marsairforce/vusbtiny/pcb/eagle/vusbtiny.brd

## EAGLE design pcb/eagle/vusbtiny.brd (2018-04-26)

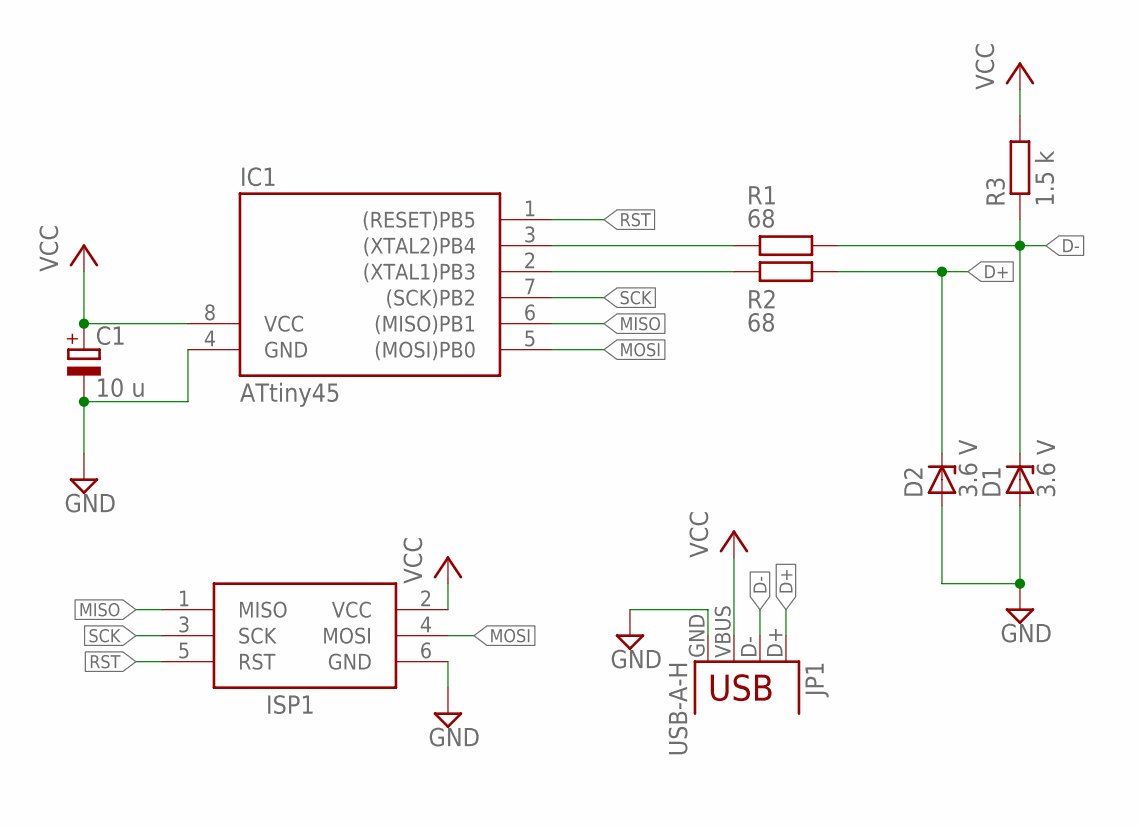
[picture p5: schematic vusbtiny.sch]

Parts:
C1: 10 u; E2,5-5
D1, D2: 3.6 V; DO34Z7
IC1: ATtiny45; DIL08
ISP1: AVRISP-6; AVRISP
JP1: USB-A-H
R1, R2: 68; 0207/10
R3: 1.5 k; 0207/10

Connections:
D+: D2.C, JP1.D+, R2.2
D-: D1.C, JP1.D-, R1.2, R3.1
GND: C1.-, D1.A, D2.A, IC1.4 (GND), ISP1.6 (GND), JP1.GND
MISO: IC1.6 ((MISO)PB1), ISP1.1 (MISO)
MOSI: IC1.5 ((MOSI)PB0), ISP1.4 (MOSI)
unnamed: IC1.3 ((XTAL2)PB4), R1.1
unnamed: IC1.2 ((XTAL1)PB3), R2.1
RST: IC1.1 ((RESET)PB5), ISP1.5 (RST)
SCK: IC1.7 ((SCK)PB2), ISP1.3 (SCK)
VCC: C1.+, IC1.8 (VCC), ISP1.2 (VCC), JP1.VBUS, R3.2

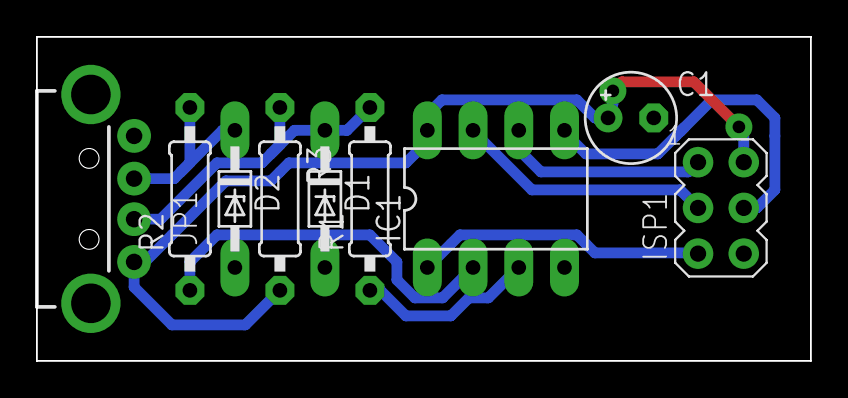
[picture p6: board vusbtiny.brd from above]

Board: 2 copper layers, 43.0 x 18.0 mm, 9 parts (0 on the bottom side), 10 nets.
