marsairforce/vusbtiny/(commit log)

2018-04-25 set up usbconfig to work with the Digispark device
2018-04-26 move eagle cad pcb work to a subfolder
    [vusbtiny.brd, vusbtiny.sch]
2018-04-26 create a Kicad schematic for the Digispark hardware
    [digispark.kicad_pcb, digispark.sch]
2018-04-26 create a Kicad schematic for vusbtiny ISP circuit.
    [vusbtiny.kicad_pcb, vusbtiny.sch]
2018-04-26 update readme.
    adding pictures of schematic and Digispark device.
2018-04-26 description for schematic
2018-04-27 add icsp header to digispark schematic.
    picture of assembled digispark as usbtinyisp
    [digispark.sch]
